kevinmjung/PPGglove/README.md

# PPGglove
This is a repository with the devices and guides corresponding to the device. It will be regularly updated or if there are specific updates that you want to be pushed 
please email me at: kmjung@ucla.edu
