kevinmjung/PPGglove/PPGGlovebottom.png

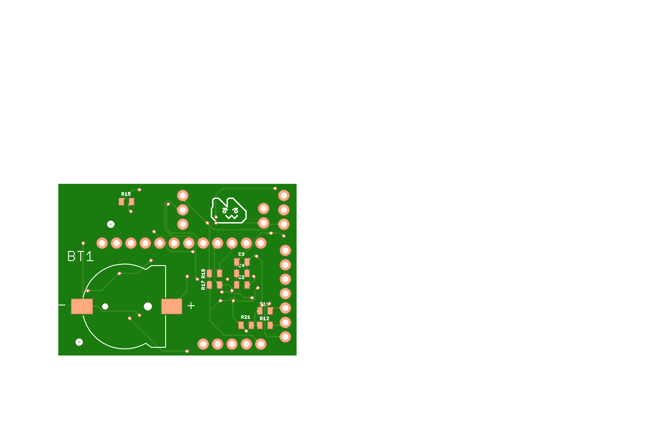
PPGGlovebottom.png
