kevinmjung/PPGglove/PPGGlovetop.png

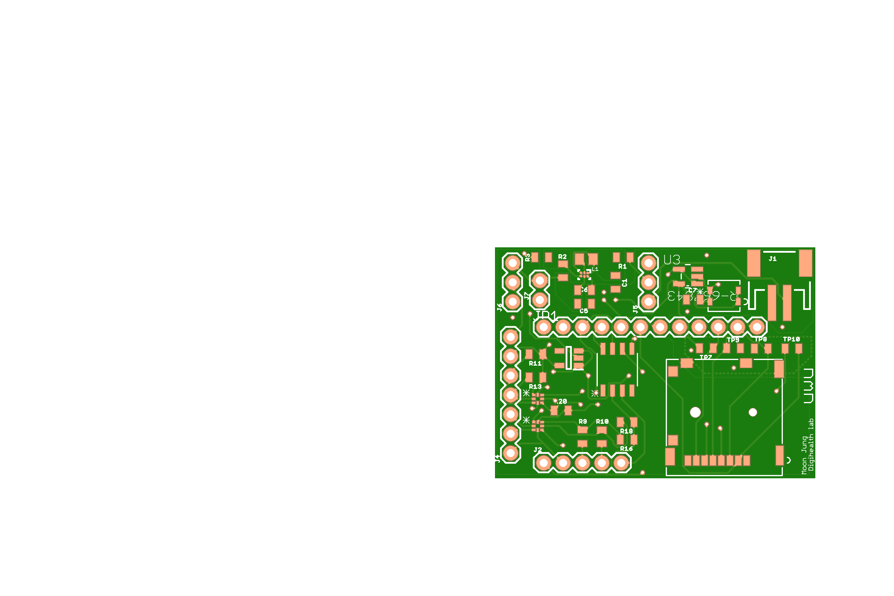
PPGGlovetop.png
