kevinmjung/PPGglove/PPGGlove.brd

## EAGLE design PPGGlove.brd (2022-10-02)

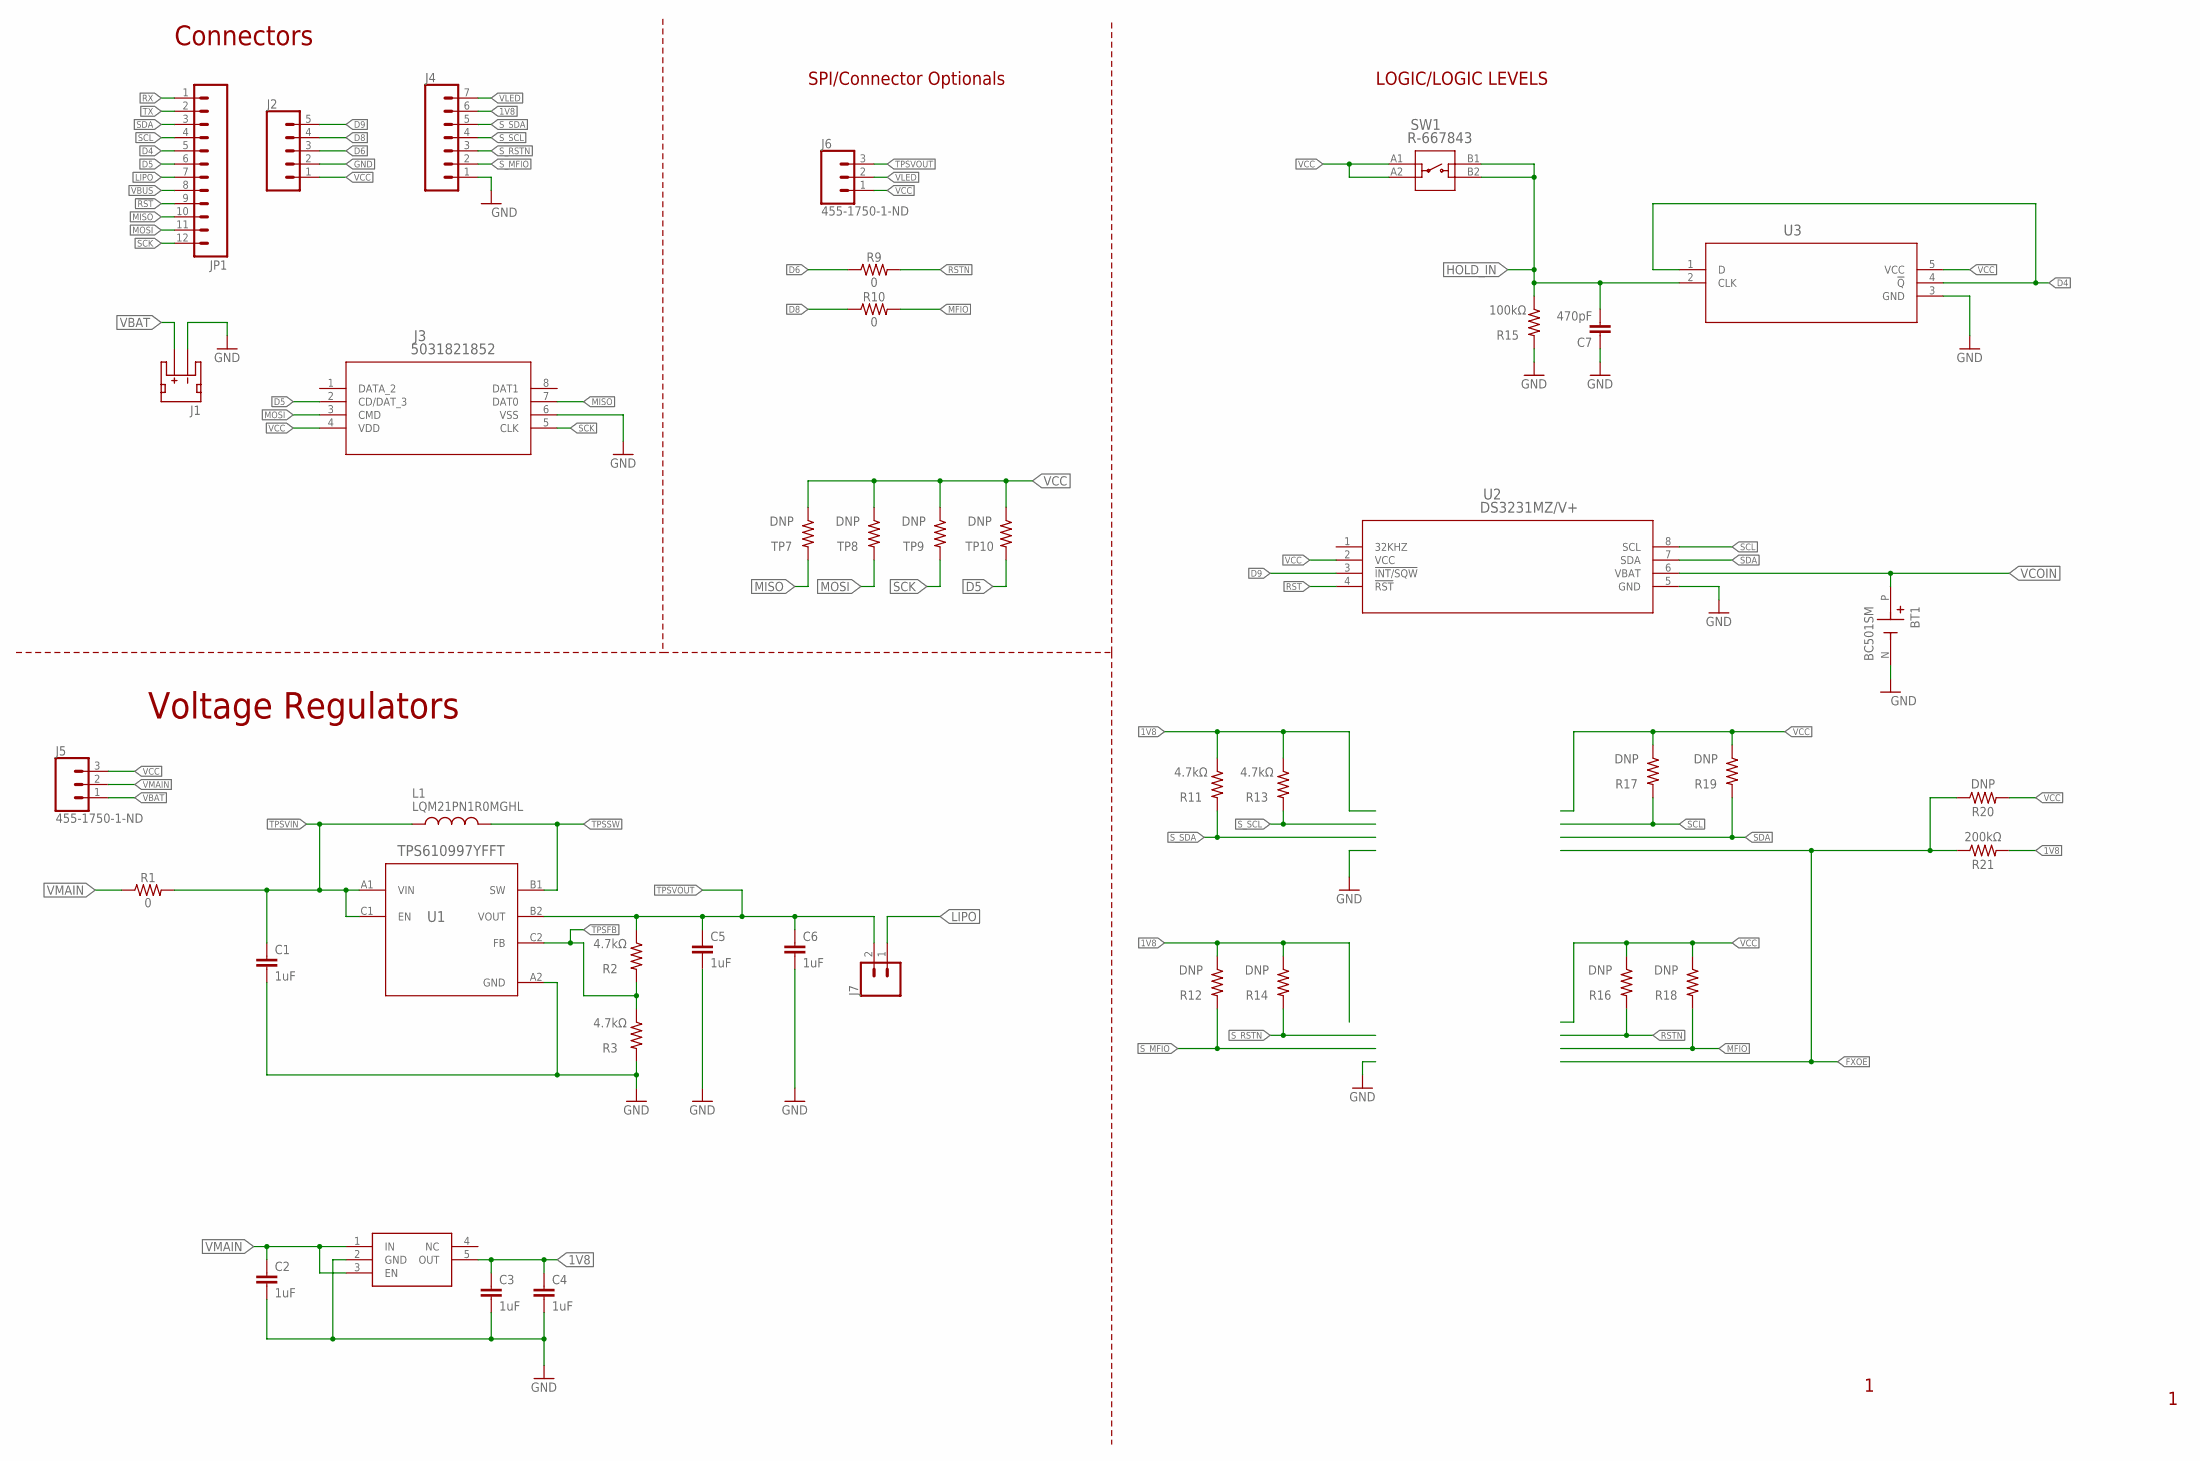
[picture p3: schematic PPGGlove.sch]

Parts:
BT1: BC501SM; BAT_BC501SM
C1, C2, C3, C4, C5, C6: 1uF; 0805
C7: 470pF; 0805
IC1: TPS7A0318DBVR; SOT95P280X145-5N
J1: JST_2MM_MALE; JST-2-SMD
J2: CONN_05; 1X05
J3: 5031821852; 503182-1852_MOL
J4: CONN_07; 1X07
J5, J6: 455-1750-1-ND; 1X03
J7: CONN_02; 1X02
JP1: M12PTH; 1X12
L1: LQM21PN1R0MGHL; INDC2012X100N
R1, R9, R10: 0; 0805
R2, R3, R11, R13: 4.7kΩ; 0805
R12, R14, R16, R17, R18, R19, R20: DNP; 0805
R15: 100kΩ; 0805
R21: 200kΩ; 0805
SW1: R-667843; R-667843_MIT
TP7, TP8, TP9, TP10: DNP; 0805
U1: TPS610997YFFT; YFF0006AFAD
U2: DS3231MZ/V+; 21-0041B_8_MXM
U5: U3; DBV5

Connections:
1V8: C3.1, C4.1, IC1.5 (OUT), J4.6, R11.1, R12.1, R13.1, R14.1, R21.2
!RST: JP1.9
D4: JP1.5, U5.1 (D), U5.4 (!Q)
D5: J3.2 (CD/DAT_3), JP1.6, TP10.2
D6: J2.3, R9.1
D8: J2.4, R10.1
D9: J2.5, U2.3 (!INT/SQW)
FXOE: R20.1, R21.1
GND: BT1.N (-), C1.2, C2.2, C3.2, C4.2, C5.2, C6.2, C7.1, IC1.2 (GND), J1.1 (-), J2.2, J3.6 (VSS), J4.1, R3.2, R15.2, U1.A2 (GND), U2.5 (GND), U5.3 (GND)
HOLD_IN: C7.2, R15.1, SW1.B1, SW1.B2, U5.2 (CLK)
LIPO: J7.1, JP1.7
MFIO: R10.2, R18.2
MISO: J3.7 (DAT0), JP1.10, TP7.2
MOSI: J3.3 (CMD), JP1.11, TP8.2
RST: U2.4 (!RST)
RSTN: R9.2, R16.2
RX: JP1.1
SCK: J3.5 (CLK), JP1.12, TP9.2
SCL: JP1.4, R17.2, U2.8 (SCL)
SDA: JP1.3, R19.2, U2.7 (SDA)
S_MFIO: J4.2, R12.2
S_RSTN: J4.3, R14.2
S_SCL: J4.4, R13.2
S_SDA: J4.5, R11.2
TPSFB: R2.2, R3.1, U1.C2 (FB)
TPSSW: L1.2, U1.B1 (SW)
TPSVIN: C1.1, L1.1, R1.2, U1.A1 (VIN), U1.C1 (EN)
TPSVOUT: C5.1, C6.1, J6.3, J7.2, R2.1, U1.B2 (VOUT)
TX: JP1.2
VBAT: J1.2 (+), J5.1
VBUS: JP1.8
VCC: J2.1, J3.4 (VDD), J5.3, J6.1, R16.1, R17.1, R18.1, R19.1, R20.2, SW1.A1, SW1.A2, TP7.1, TP8.1, TP9.1, TP10.1, U2.2 (VCC), U5.5 (VCC)
VCOIN: BT1.P (+), U2.6 (VBAT)
VLED: J4.7, J6.2
VMAIN: C2.1, IC1.1 (IN), IC1.3 (EN), J5.2, R1.1

Notes on the sheet:
Connectors
Voltage Regulators
SPI/Connector Optionals
LOGIC/LOGIC LEVELS

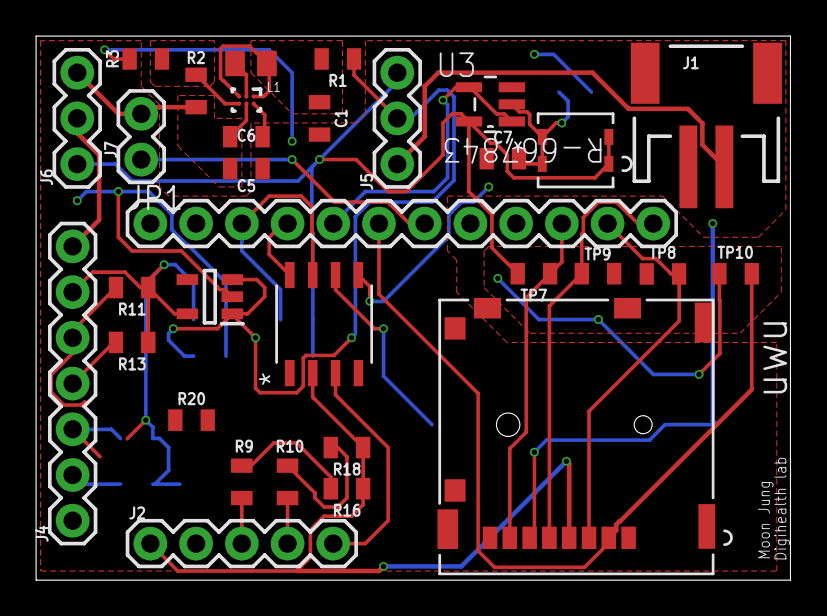
[picture p4: board PPGGlove.brd from above]

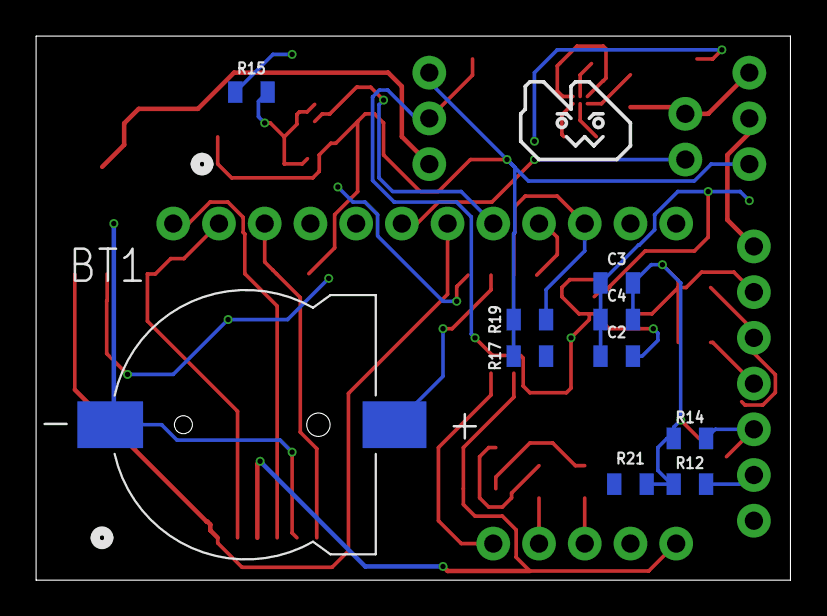
[picture p5: board PPGGlove.brd from below]

Board: 2 copper layers, 41.9 x 30.2 mm, 42 parts (10 on the bottom side), 30 nets.
