kevinmjung/PPGglove/(notices)

Notices in the files:
PPGGlove.brd:
Copyright (c) 2016-2017 Arduino LLC. All right reserved. EAGLE Design Rules
parts and their libraries:
SparkFun-Connectors: Licensing: Creative Commons ShareAlike 4.0 International - https://creativecommons.org/licenses/by-sa/4.0
COPYRIGHT: Copyright (C) 2022 Ultra Librarian. All rights reserved.
